WolfgangFranke/Solar-Powered_Hue-Module/2_HueModule_fromWhiteE27bulb/readme.txt

This folder contains how to hack a Philips Hue White E27 bulb to get a ordinaty Hue Zigbee module.
And connecting a Zigbee switch module to open/close the Roller Blind remotely by your Home Automation application. I show you how to re-use an ordinary Philips Hue module from an older Hue White E27 bulb.
