WolfgangFranke/Solar-Powered_Hue-Module/4_Arduino_ESP32_SolarPowerMeter/Solar_Power_Meter_ESP32_INA219_OLED-SH1106_v360/readme.txt

This folder contains the Arduino scetch. 
Do not forget to fill the "my_IoT_credentials.h" file with your personal data of your ESP32 device and for ThingSpeak.
