WolfgangFranke/Solar-Powered_Hue-Module/1_RollerBlind/1_RollerBlind_Photo05.jpg

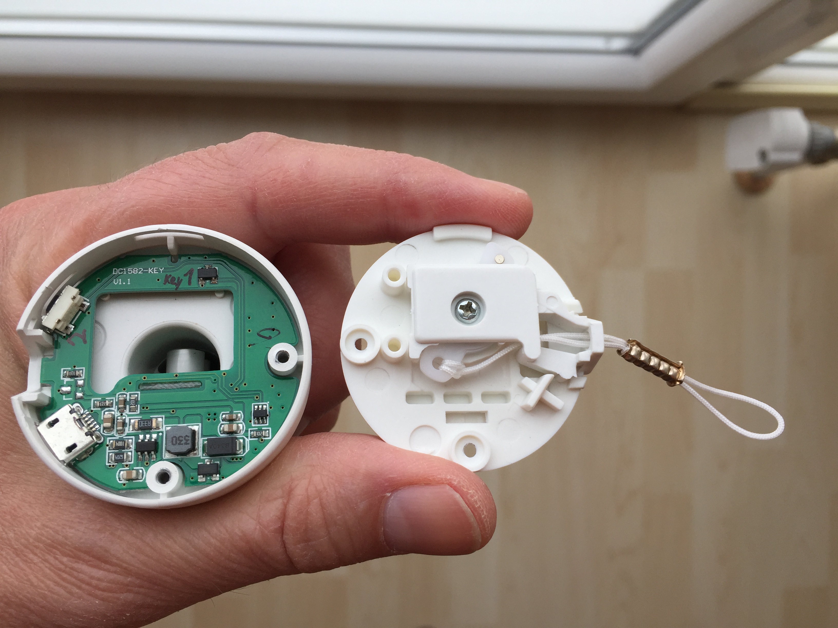
1_RollerBlind/1_RollerBlind_Photo05.jpg
