WolfgangFranke/Solar-Powered_Hue-Module/2_HueModule_fromWhiteE27bulb/2_Philips_Hue_White_Bulb_Hack_Photo01.jpg

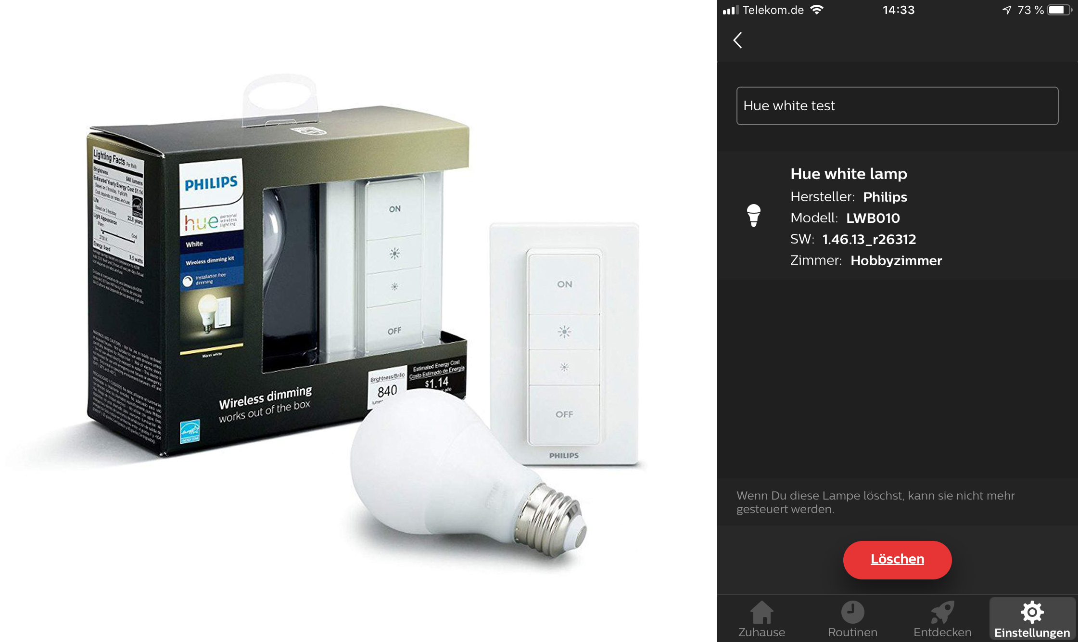
2_HueModule_fromWhiteE27bulb/2_Philips_Hue_White_Bulb_Hack_Photo01.jpg
