WolfgangFranke/Solar-Powered_Hue-Module/3_SolarModules_MPPT-Controller/3_SolarModules_02.jpg

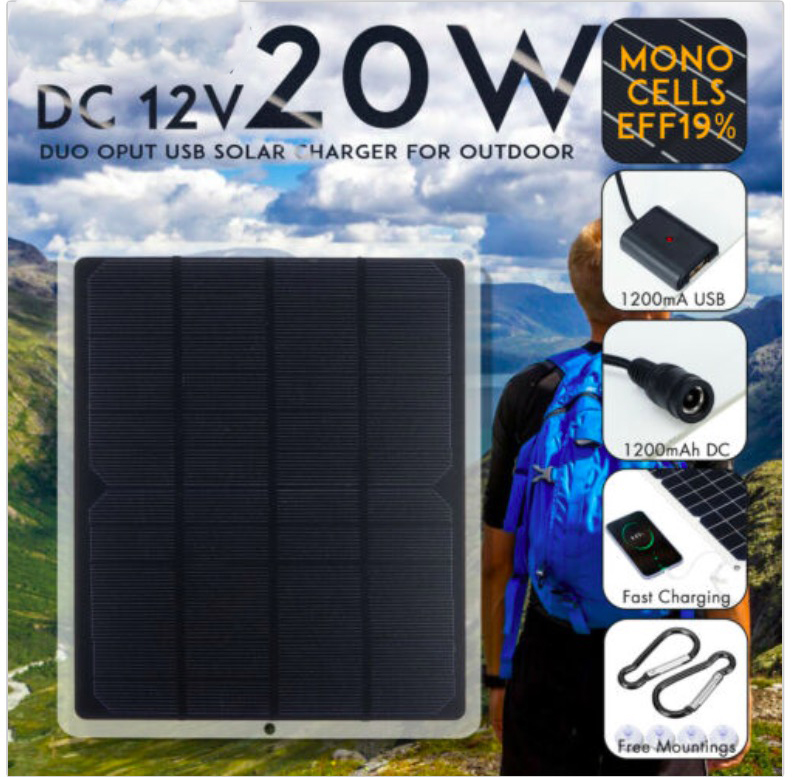
3_SolarModules_MPPT-Controller/3_SolarModules_02.jpg
