WolfgangFranke/Solar-Powered_Hue-Module/3_SolarModules_MPPT-Controller/3_SolarModules_04_MPPT_Controller_LT3652.jpg

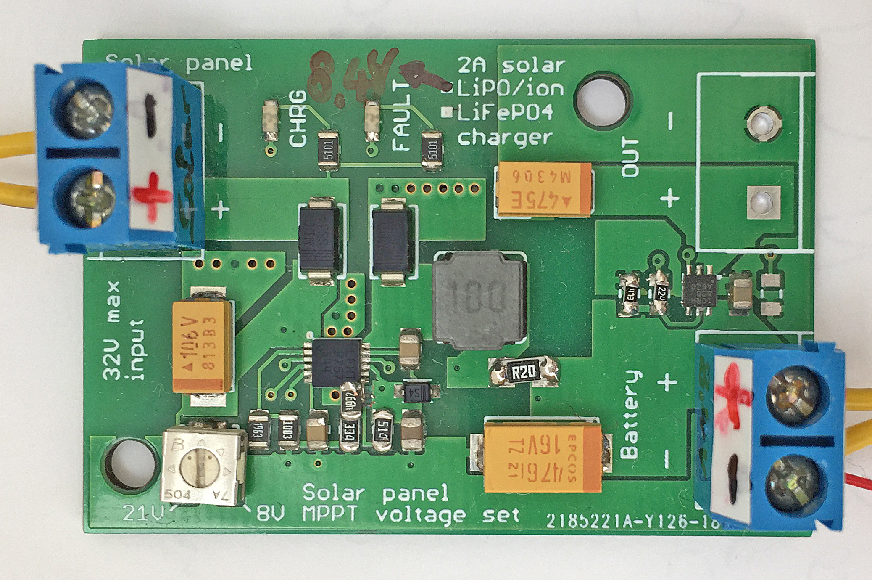
3_SolarModules_MPPT-Controller/3_SolarModules_04_MPPT_Controller_LT3652.jpg
