WolfgangFranke/Solar-Powered_Hue-Module/4_Arduino_ESP32_SolarPowerMeter/4_Arduino_ESP32_SolarPowerMeter_Photo02.jpg

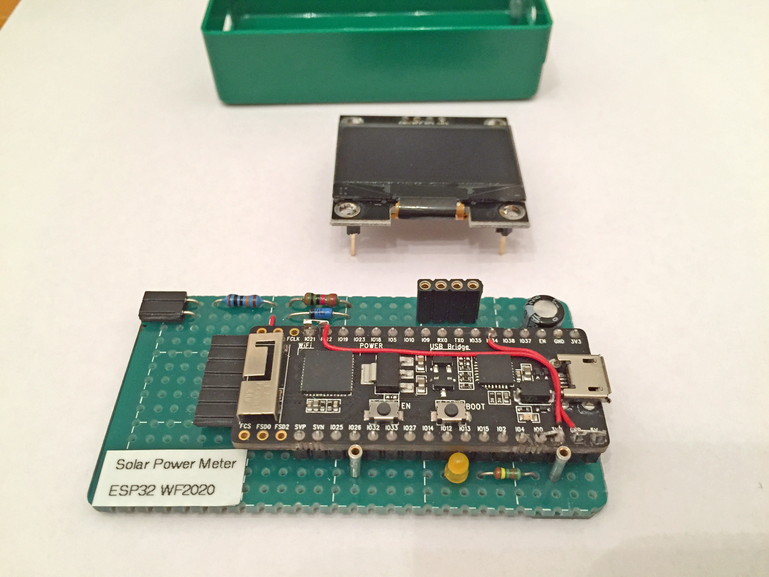
4_Arduino_ESP32_SolarPowerMeter/4_Arduino_ESP32_SolarPowerMeter_Photo02.jpg
