WolfgangFranke/Solar-Powered_Hue-Module/5_PutAllPiecesTogether/5_PutAllPiecesTogether_Photo02.jpg

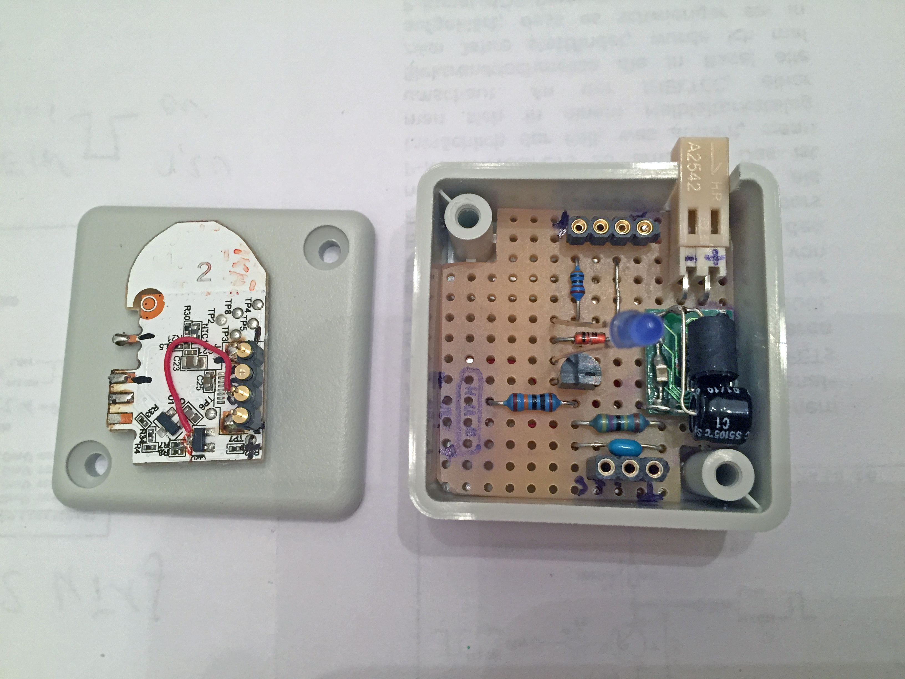
5_PutAllPiecesTogether/5_PutAllPiecesTogether_Photo02.jpg
